Zeusezhan/fish/fish.ioc

Mcu.UserName=STM32F407ZGTx
PA10.GPIO_Label=STEP_RX
PA10.Signal=USART1_RX
PA13.Signal=SYS_JTMS-SWDIO
PA14.Signal=SYS_JTCK-SWCLK
PA2.Signal=USART2_TX
PA3.Signal=USART2_RX
PA9.GPIO_Label=STEP_TX
PA9.Signal=USART1_TX
PB10.Signal=USART3_TX
PB11.Signal=USART3_RX
PB6.Signal=I2C1_SCL
PB7.Signal=I2C1_SDA
PD10.Signal=GPIO_Output
PD8.Signal=GPIO_Output
PE0.Signal=GPIO_Input
PE1.Signal=GPIO_Input
PE2.Signal=GPIO_Input
PH0-OSC_IN.Signal=RCC_OSC_IN
PH1-OSC_OUT.Signal=RCC_OSC_OUT
