Zeusezhan/fish/Core/Inc/main.h

#define YAW_OUT_MAX_RPM         (30.0f)
#define STEP_TX_Pin GPIO_PIN_9
#define STEP_TX_GPIO_Port GPIOA
#define STEP_RX_Pin GPIO_PIN_10
#define STEP_RX_GPIO_Port GPIOA
