Zeusezhan/fish/Hardware/wireless_uart.h

#ifndef __WIRELESS_UART_H
#define __WIRELESS_UART_H

/* ============================================================
 * 无线串口 / VOFA+ 波形上报
 *
 * 【用途】用 USART2(PA2=TX, PA3=RX, 9600 8N1)把航向闭环的
 *         目标值和当前值发出去, 在 VOFA+ 上位机里实时看曲线;
 *         同时用同一串口接收 PC 发来的 "kp,kd\n" 在线调参命令。
 *
 * 【接线】USART2 是 3.3V TTL 电平, 不能直接接电脑 USB!
 *         接无线模块(如 HC-05 / ESP-01)或 CH340 USB-TTL 小板:
 *             模块 RXD  <-  PA2 (单片机 TX)
 *             模块 TXD  ->  PA3 (单片机 RX, 接收 PC 发来的 PID 参数)
 *             模块 GND  <-> GND
 *         无线模块的波特率必须也是 9600, 否则收到的全是乱码。
 *
 * 【VOFA+ 设置】数据格式选 "FireWater", 波特率选 9600。
 *         FireWater 是纯文本协议: 一帧就是一串用逗号分成的数字,
 *         以 '\n' 结尾。本文件每帧发 4 个通道:
 *             第 0 通道 = 目标航向角 (度)
 *             第 1 通道 = 当前航向角 (度)
 *             第 2 通道 = 当前 Kp (回显, 用来确认参数已生效)
 *             第 3 通道 = 当前 Kd (回显, 用来确认参数已生效)
 *         两个角度用的是同一套坐标, 叠在一起就能看出"还差多少"。
 *
 * 【在线调 PD】两种方式:
 *   1. 数据发送框手打 "kp,kd\n", 例如 6.0,0.4(两个一起设);
 *   2. 用 VOFA+ 控件: 加两个"滑动条", 分别绑定命令 "P%f\n" 和
 *      "D%f\n", 拖动滑块即自动发送, 不用手动发。
 *   芯片收到后实时更新 g_yaw_kp / g_yaw_kd, 波形立即变化就是生效。
 * ============================================================ */

#include "main.h"

/* ---- 上报周期(ms) ----
 * 别设太小: 上一次没发完时 HAL_UART_Transmit_DMA 会返回 HAL_BUSY,
 * 那一帧就丢了, 波形上表现为随机掉点。
 *
 * ★ 9600bps 下的带宽核算(无线蓝牙模块固定 9600, 不能改):
 *     可用吞吐 = 9600 / 10 = 960 字节/秒
 *     一帧 6 通道约 40 字节 => 单帧占用约 42ms
 *       周期 60ms : 占用 70%  -> 下行命令余量不足, 滑块容易失效
 *       周期 90ms : 占用 47%  -> 当前取值, 波形连续且留足下行余量
 *       周期 120ms: 占用 35%  -> 更稳, 但波形刷新略慢
 *   若调参时发现波形掉点、或 VOFA+ 发的 "P6.0" 不生效,
 *   优先把这里调大到 80u。 */
#define WIRELESS_REPORT_PERIOD_MS   (90u)

/**
  * @brief  初始化无线串口上报模块
  * @note   在 main() 的初始化段调用一次(须在 MX_USART2_UART_Init() 之后)。
  *         只复位内部计时并启动下行接收, 串口本身已由 MX_USART2_UART_Init() 配好。
  */
void Wireless_Init(void);

/**
  * @brief  启动下行接收(PC -> 芯片): 用中断逐字节接收 VOFA+ 发来的
  *         "kp,kd\n" 命令, 解析成功后实时更新 g_yaw_kp / g_yaw_kd。
  * @note   Wireless_Init() 内部已自动调用, 一般不需要手动调。
  *         接收引脚 PA3 与 USART2 中断由 CubeMX 配置, 无需额外初始化。
  */
void Wireless_StartReceive(void);

/**
  * @brief  上报"目标航向 + 当前航向"(供定时器中断回调调用)
  * @param  target_yaw_deg   目标航向角(度)
  * @param  current_yaw_deg  当前陀螺仪航向角(度)
  * @note   ★ 这个函数是"非阻塞"的, 内部用 DMA 把数据丢出去就返回,
  *           不会占用 CPU 等待, 所以可以放心在中断里调用。
  *         内部带周期限频, 比 WIRELESS_REPORT_PERIOD_MS 更密的调用
  *         会被自动跳过, 所以直接无脑调用即可。
  *         帧格式(VOFA+ FireWater): "目标,当前,Kp,Kd,误差,输出\n"
  *           CH0 = 目标航向
  *           CH1 = 当前航向
  *           CH2 = 当前 Kp(确认滑块生效)
  *           CH3 = 当前 Kd
  *           CH4 = 航向误差(目标-当前), 调 PD 主要看这条
  *           CH5 = 航向环输出修正量(RPM), 判断闭环是否真的在起作用
  */
void Wireless_SendYaw(float target_yaw_deg, float current_yaw_deg);

/**
  * @brief  上报航向误差(度) = 目标角 - 当前角
  * @param  target_yaw_deg   目标航向角(度)
  * @param  current_yaw_deg  当前陀螺仪航向角(度)
  * @note   内部与 Wireless_SendYaw 相同: 每帧发 6 个通道
  *         (目标/当前/Kp/Kd/误差/输出), 两角之差在 VOFA+ 里用
  *         两根曲线的差就能看出来。
  */
void Wireless_SendYawError(float target_yaw_deg, float current_yaw_deg);

/**
  * @brief  按当前实际状态上报(目标 + 当前 + Kp + Kd + 误差 + 输出)
  * @note   所有值都取自全局变量:
  *             目标  = g_yaw_target
  *             当前  = jy901s_data.yaw_continuous
  *             Kp    = g_yaw_kp
  *             Kd    = g_yaw_kd
  *             误差  = 目标 - 当前
  *             输出  = g_yaw_output (RPM 执行量)
  *         已经算好帧内容并做了周期限频, 可以贴到主循环里反复调用,
  *         不会刷爆串口。
  *         ★ 上报不受闭环开关影响: 即使 g_yaw_loop_enable = 0,
  *           只要没到达上传周期就会照常发, 方便上电先验证 IMU 和接线。
  *         由于回传了 Kp/Kd, 在 VOFA+ 里拖动滑块后能立刻看到
  *         对应通道的数值变化 —— 这就是"参数已发送成功"的确认。
  *         ★ CH5(输出)即使闭环关着也照常发 0, 正好用来确认
  *           "没修正"到底是因为闭环没开, 还是因为算出来被限幅。
  */
void Wireless_ReportYaw(void);

#endif /* __WIRELESS_UART_H */
