Zeusezhan/fish/(commit log)

2026-10-19 move
    Updated wheel direction definitions and speed calculations to reflect actual wiring and inverse kinematics.
2026-10-26 chore: 停止跟踪 Keil 编译产物与本机布局文件
    仓库里已提交的 .o/.d/.crf/.axf/.dep/.lst/构建日志等编译产物
    以及 uvguix 窗口布局文件会导致每次编译后工作区变脏、与协作者
    改动互相覆盖。改为由 .gitignore 忽略, 仅保留工程配置与可烧录
    产物(fish.uvprojx/fish.uvoptx/fish.hex/fish.sct/启动文件)。
